Fried-Electronics/FE2201-MEPOS-STM32F405RGT6/KiCad/Pictures/220830 - PCB.jpg

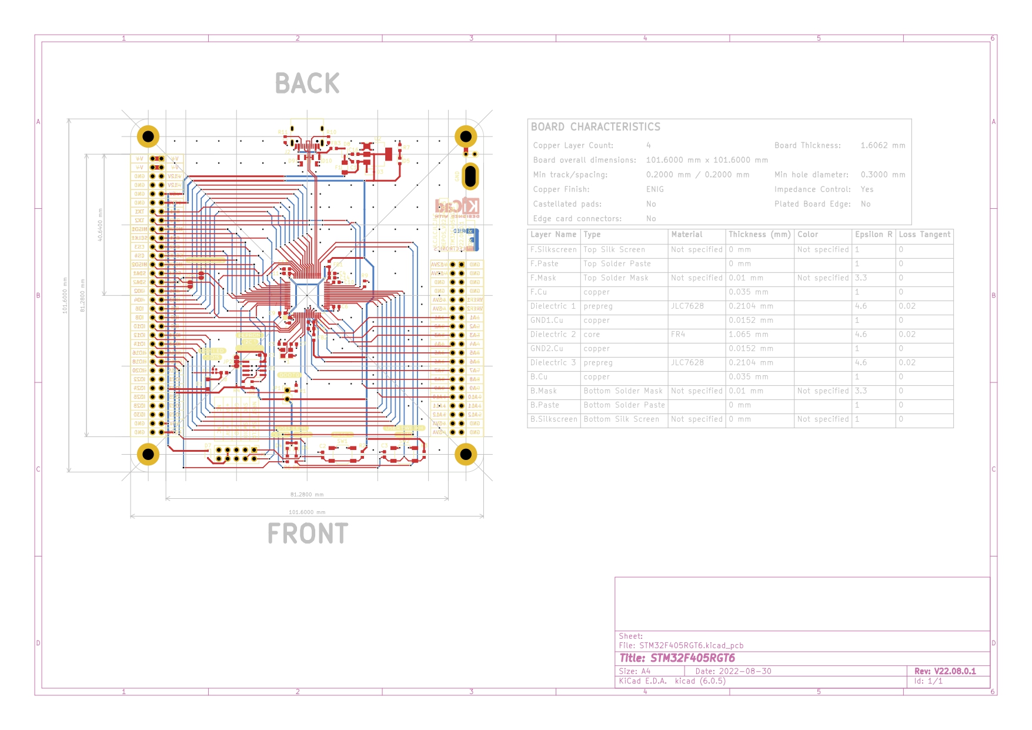
KiCad/Pictures/220830 - PCB.jpg
