Fried-Electronics/FE2201-MEPOS-STM32F405RGT6/KiCad/3D Models/STM32F405RGT6.step

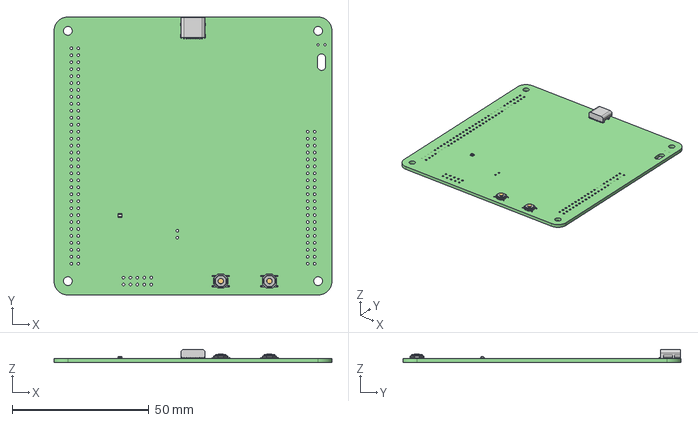
[picture p7: CAD file, 2022-09-21]
KiCad/3D Models/STM32F405RGT6.step
101.6 x 101.6 x 4.87 mm
STM32F405RGT6 PCB
