Fried-Electronics/FE2201-MEPOS-STM32F405RGT6/KiCad/220830 - Schematic.pdf

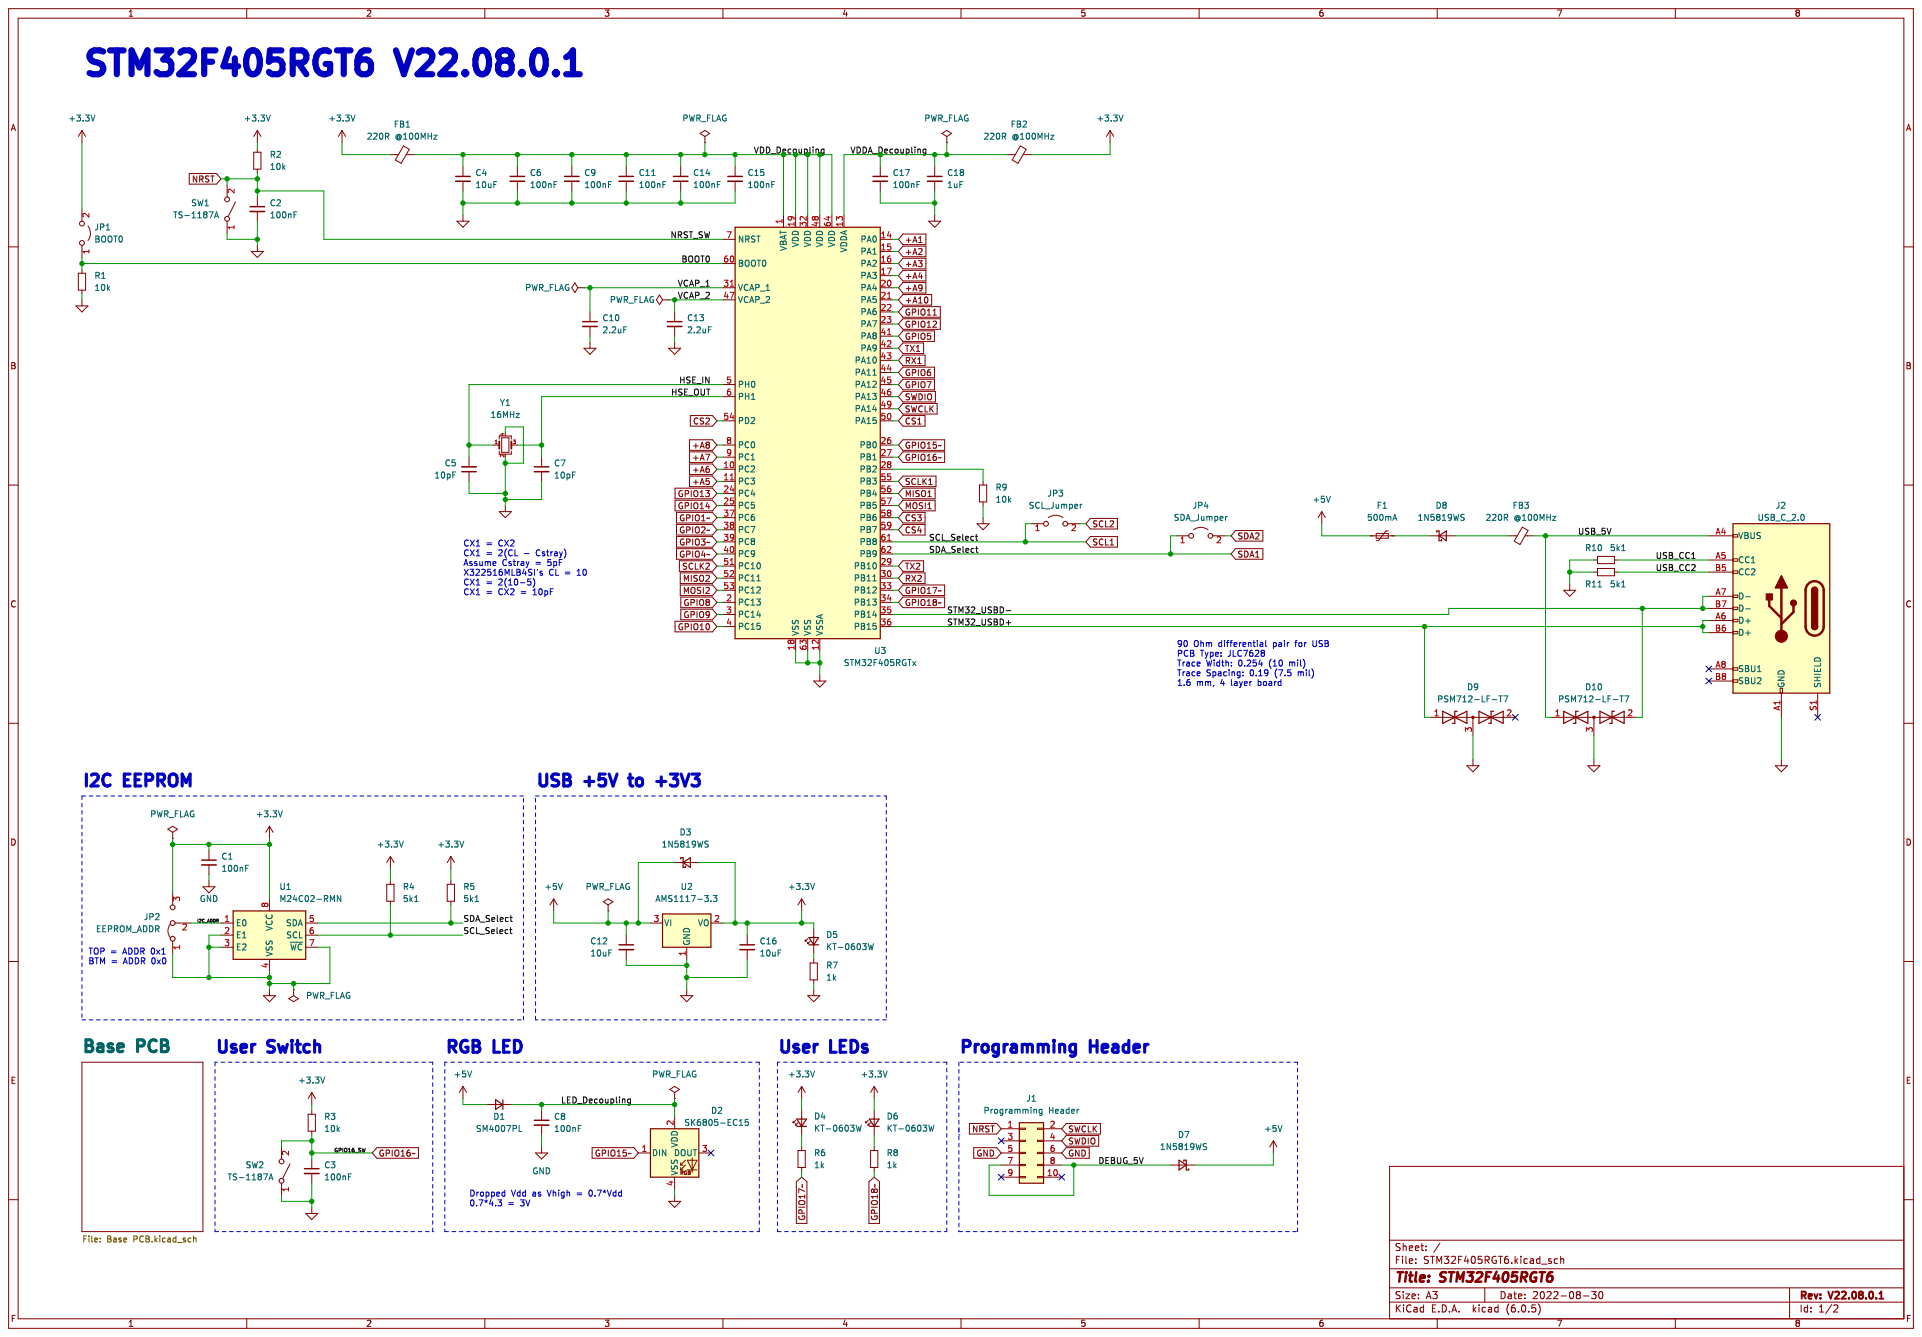
[picture p8: page 1]

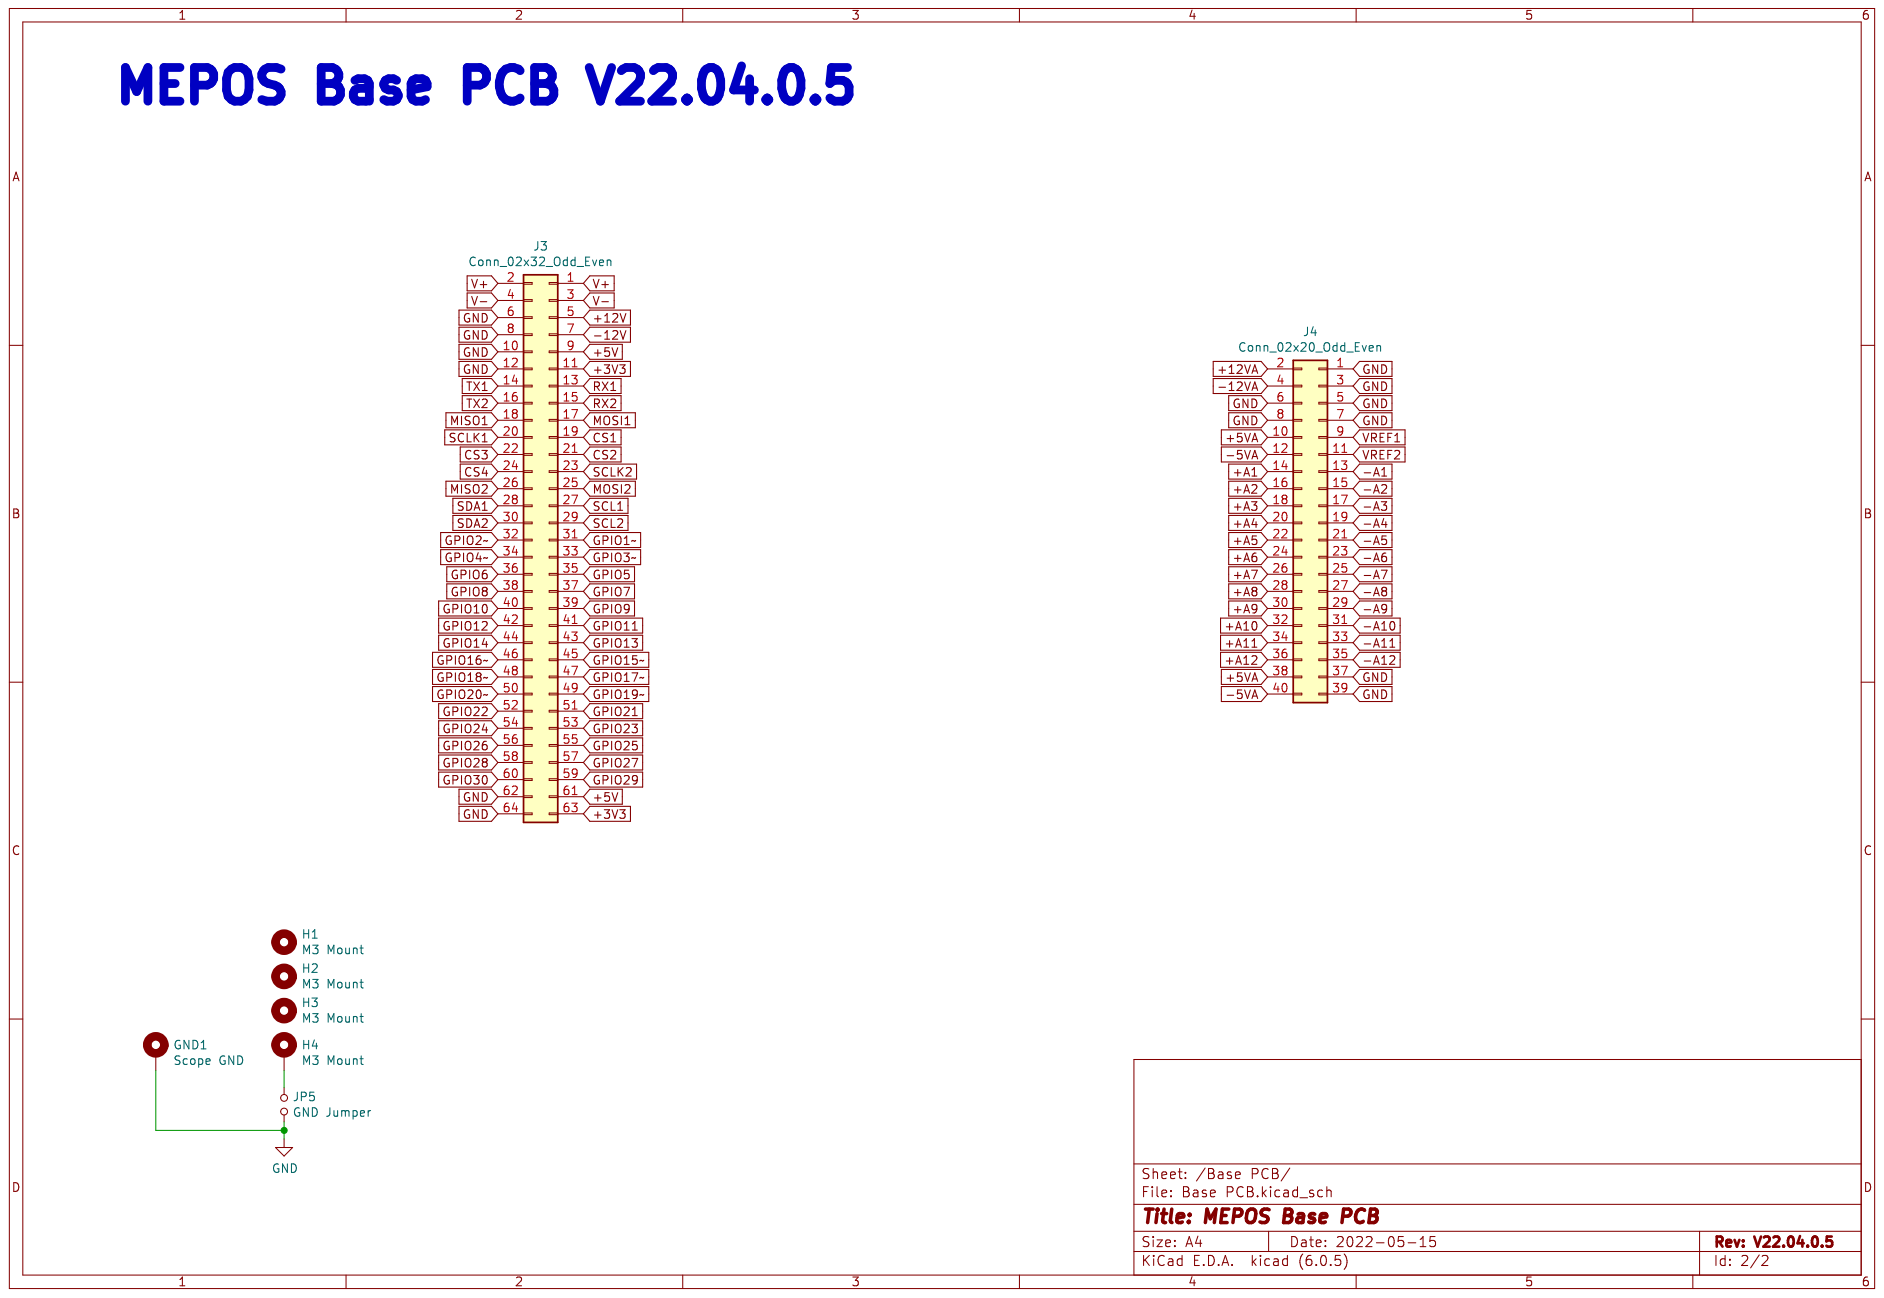
[picture p9: page 2]
