Fried-Electronics/FE2201-MEPOS-STM32F405RGT6/KiCad/220830 - PCB.pdf

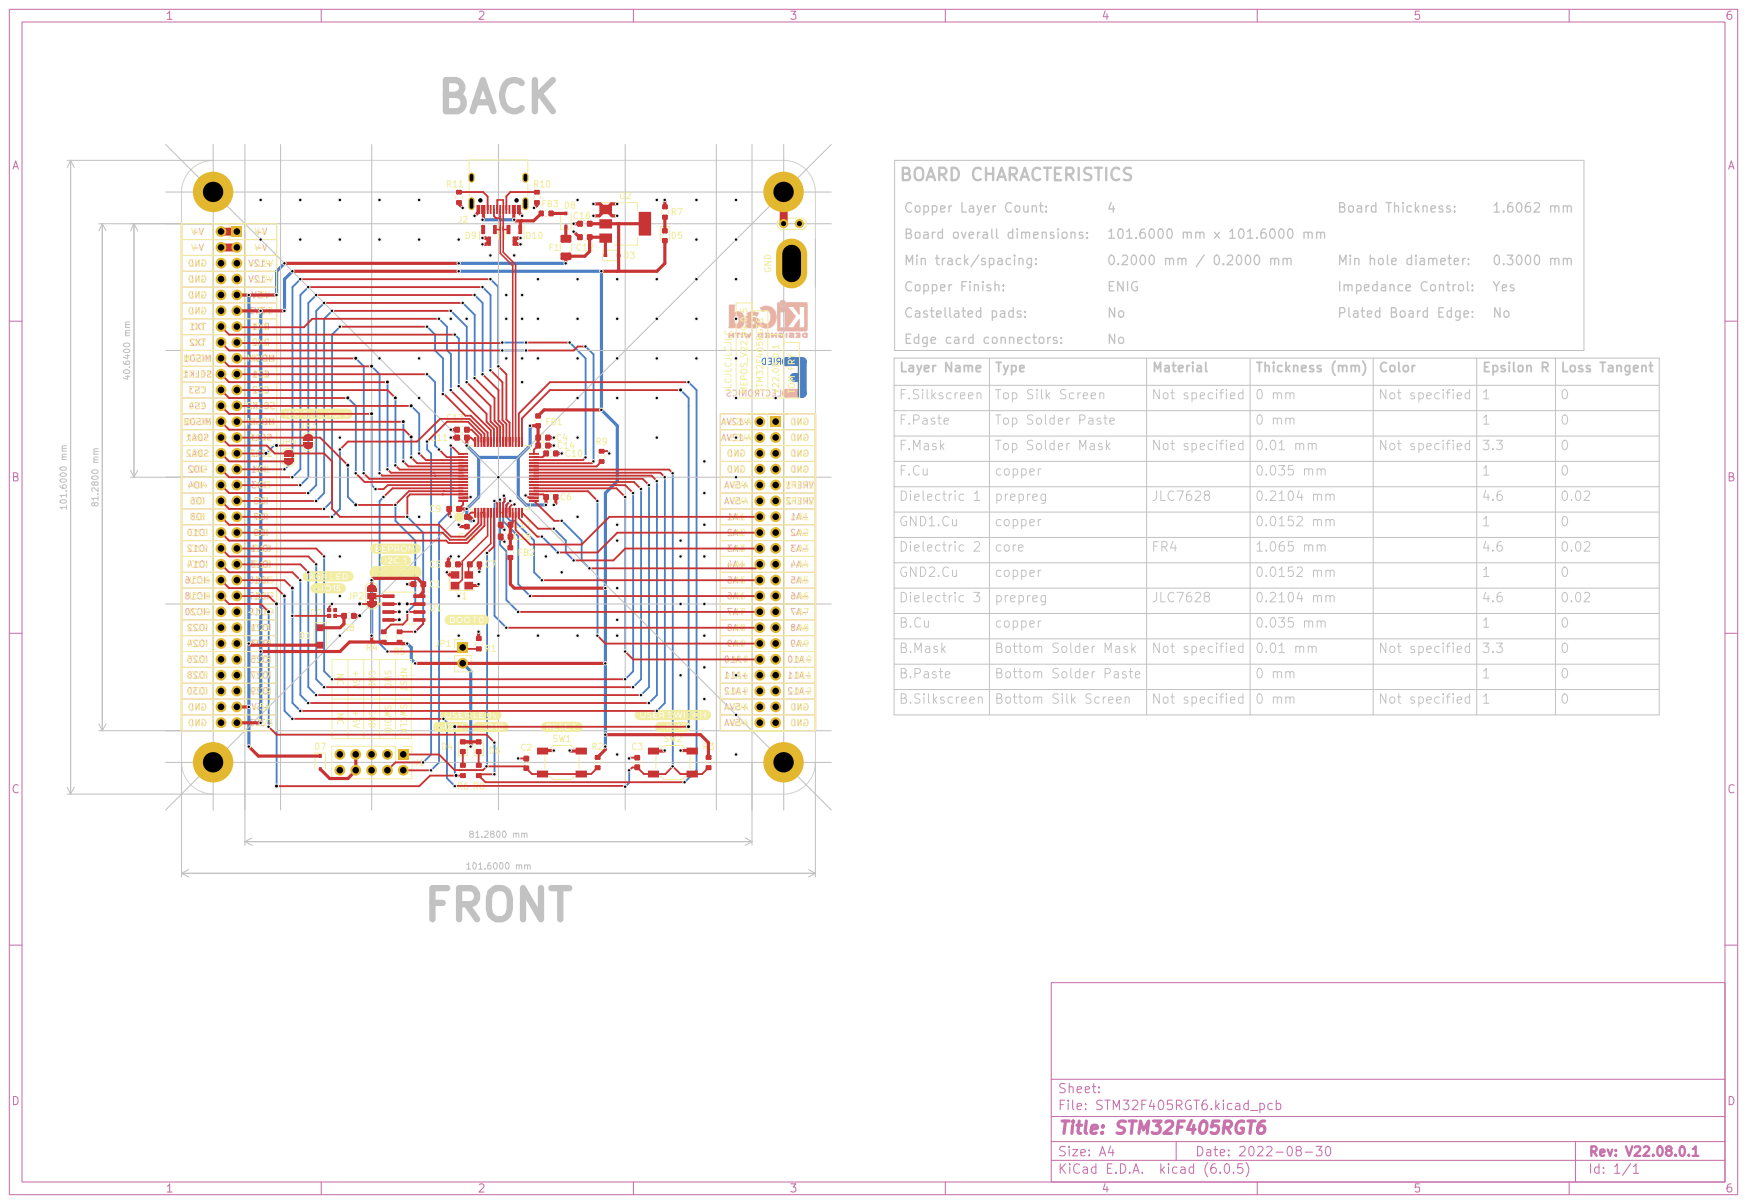
[picture p10: page 1]
