Fried-Electronics/FE2201-MEPOS-STM32F405RGT6/KiCad/STM32F405RGT6.kicad_pcb

## KiCad design KiCad/STM32F405RGT6.kicad_pcb (2022-09-21)

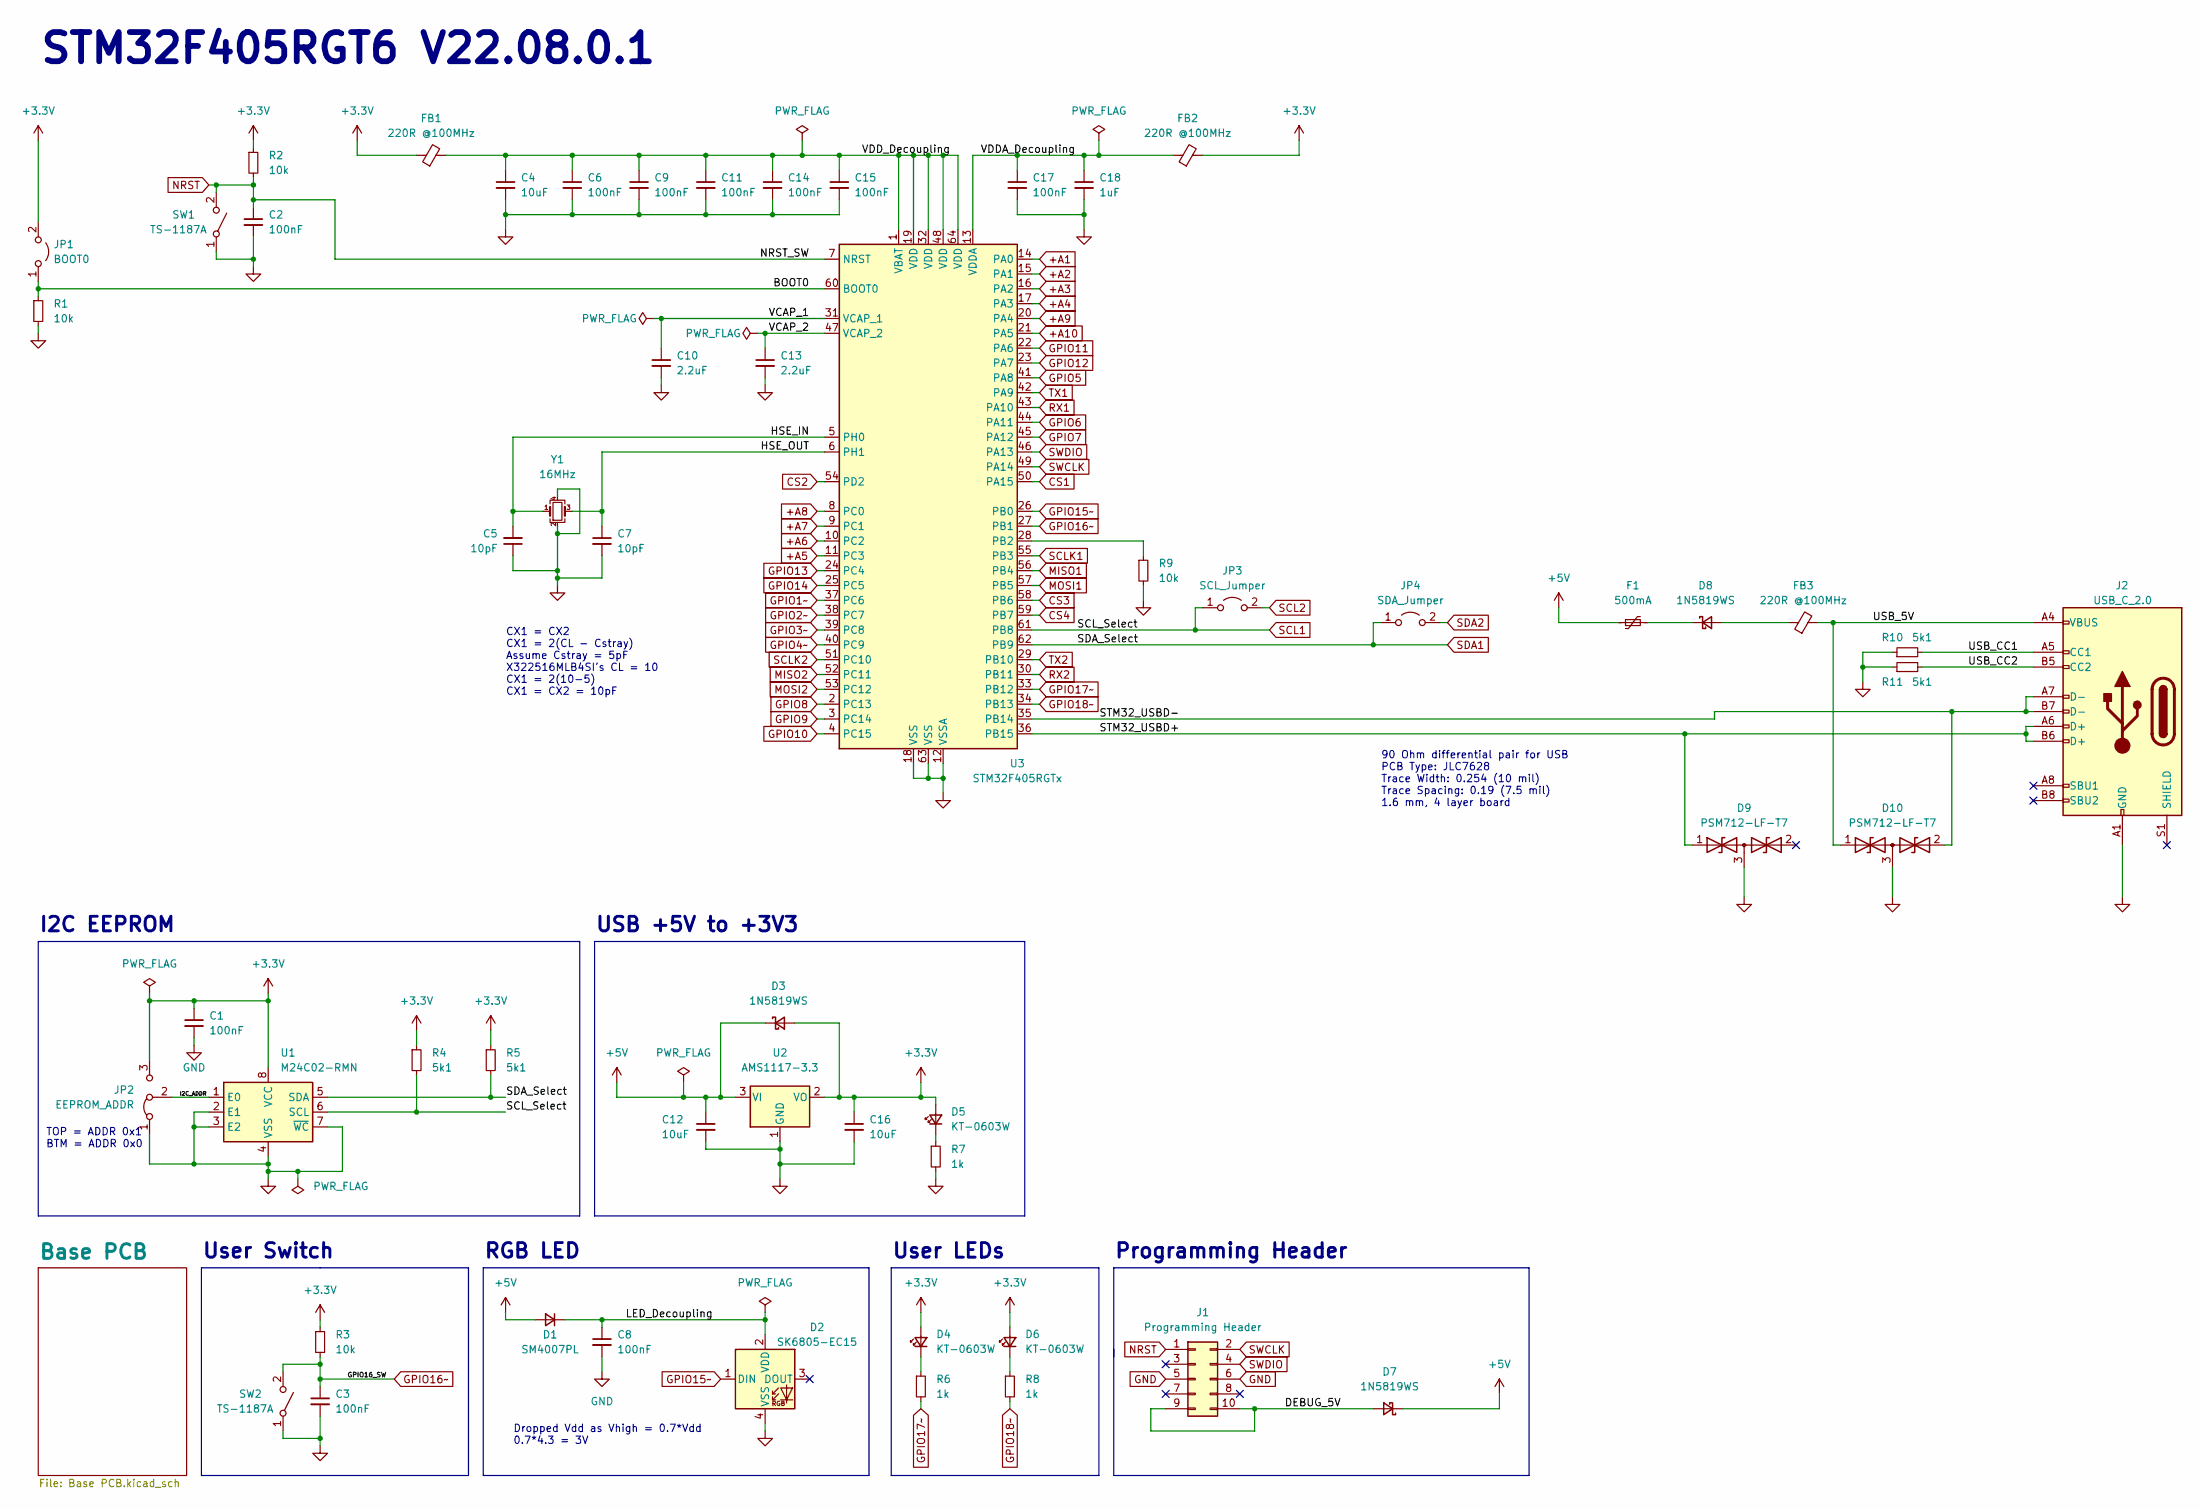
[picture p11: schematic STM32F405RGT6.kicad_sch]

Parts:
C1, C2, C3, C6, C8, C9, C11, C14, C15, C17: 100nF; C_0603_1608Metric; Part Number CC0603KRX7R9BB104; JLCPCB Part # C14663
C4, C12, C16: 10uF; C_0603_1608Metric; Part Number CL10A106KP8NNNC; JLCPCB Part # C19702
C5, C7: 10pF; C_0603_1608Metric; Part Number CL10C100JB8NNNC; JLCPCB Part # C1634
C10, C13: 2.2uF; C_0603_1608Metric; Part Number CL10A225KO8NNNC; JLCPCB Part # C23630
C18: 1uF; C_0603_1608Metric; Part Number CL10A105KB8NNNC; JLCPCB Part # C15849
D1: SM4007PL; D_SOD-123F; Part Number SM4007PL; JLCPCB Part # C64898
D2: SK6805-EC15
D3, D7, D8: 1N5819WS; D_SOD-323; Part Number 1N5819WS; JLCPCB Part # C191023
D4, D5, D6: KT-0603W; LED_0603_1608Metric; JLCPCB Part # C2290
D9, D10: PSM712-LF-T7; SOT-23; JLCPCB Part # C32677
F1: 500mA; Fuse_1206_3216Metric; Part Number JK-nSMD050-30; JLCPCB Part # C720075
FB1, FB2, FB3: 220R @100MHz; L_0603_1608Metric; Mouser Part Number 81-BLM18KG221SN1D
J1: Programming Header; PinHeader_2x05_P2.54mm_Horizontal; JLCPCB Part # C492433
J2: USB_C_2.0; USB_C_Receptacle_HRO_TYPE-C-31-M-12; Part Number TYPE-C-31-M-12; JLCPCB Part # C165948
JP1: BOOT0; PinHeader_1x02_P2.54mm_Vertical; Part Number PZ254V-11-02P; JLCPCB Part # C492401
JP2: EEPROM_ADDR; SolderJumper-3_P1.3mm_Bridged12_RoundedPad1.0x1.5mm
JP3: SCL_Jumper; SolderJumper-2_P1.3mm_Open_RoundedPad1.0x1.5mm
JP4: SDA_Jumper; SolderJumper-2_P1.3mm_Open_RoundedPad1.0x1.5mm
R1, R2, R3, R9: 10k; R_0603_1608Metric; Part Number 0603WAF1002T5E; JLCPCB Part # C25804
R4, R5, R10, R11: 5k1; R_0603_1608Metric; Part Number 0603WAF5101T5E; JLCPCB Part # C23186
R6, R7, R8: 1k; R_0603_1608Metric; Part Number 0603WAF1001T5E; JLCPCB Part # C21190
SW1, SW2: TS-1187A; SW_SPST_SKQG_WithStem; Part Number TS-1187A-B-A-B; JLCPCB Part # C318884
U1: M24C02-RMN; SOIC-8_3.9x4.9mm_P1.27mm; Mouser Part Number 511-M24C64-RMN6TP; JLCPCB Part # C79988
U2: AMS1117-3.3; SOT-223-3_TabPin2; Part Number AMS1117-3.3; JLCPCB Part # C6186
U3: STM32F405RGTx; LQFP-64_10x10mm_P0.5mm; Part Number STM32F405RGT6; JLCPCB Part # C15742
Y1: 16MHz; Crystal_SMD_3225-4Pin_3.2x2.5mm; Part Number X322516MLB4SI; JLCPCB Part # C13738

Connections:
+5V: C12.1, D1.2 (A), D3.1 (K), D7.1 (K), F1.1, U2.3 (VI); also elsewhere on the board
+A1: U3.14 (PA0); also elsewhere on the board
+A2: U3.15 (PA1); also elsewhere on the board
+A3: U3.16 (PA2); also elsewhere on the board
+A4: U3.17 (PA3); also elsewhere on the board
+A5: U3.11 (PC3); also elsewhere on the board
+A6: U3.10 (PC2); also elsewhere on the board
+A7: U3.9 (PC1); also elsewhere on the board
+A8: U3.8 (PC0); also elsewhere on the board
+A9: U3.20 (PA4); also elsewhere on the board
+A10: U3.21 (PA5); also elsewhere on the board
/BOOT0: JP1.1 (A), R1.1, U3.60 (BOOT0)
/DEBUG_5V: D7.2 (A), J1.9, J1.10
/HSE_IN: C5.2, U3.5 (PH0), Y1.1
/HSE_OUT: C7.1, U3.6 (PH1), Y1.3
/I2C_ADDR: JP2.2 (C), U1.1 (E0)
/LED_Decoupling: C8.1, D1.1 (K), D2.2 (VDD)
/STM32_USBD+: D9.1 (A1), J2.A6 (D+), J2.B6 (D+), U3.36 (PB15)
/STM32_USBD-: D10.2 (A2), J2.A7 (D-), J2.B7 (D-), U3.35 (PB14)
/USB_5V: D10.1 (A1), FB3.2, J2.A4 (VBUS), J2.A9 (VBUS), J2.B4 (VBUS), J2.B9 (VBUS)
/USB_CC1: J2.A5 (CC1), R10.2
/USB_CC2: J2.B5 (CC2), R11.2
/VCAP_1: C10.1, U3.31 (VCAP_1)
/VCAP_2: C13.1, U3.47 (VCAP_2)
/VDDA_Decoupling: C17.1, C18.1, FB2.1, U3.13 (VDDA)
/VDD_Decoupling: C4.1, C6.1, C9.1, C11.1, C14.1, C15.1, FB1.2, U3.1 (VBAT), U3.19 (VDD), U3.32 (VDD), U3.48 (VDD), U3.64 (VDD)
CS1: U3.50 (PA15); also elsewhere on the board
CS2: U3.54 (PD2); also elsewhere on the board
CS3: U3.58 (PB6); also elsewhere on the board
CS4: U3.59 (PB7); also elsewhere on the board
GND: C1.2, C2.2, C3.2, C4.2, C5.1, C6.2, C7.2, C8.2, C9.2, C10.2, C11.2, C12.2, C13.2, C14.2, C15.2, C16.2, C17.2, C18.2, D2.4 (VSS), D9.3 (common), D10.3 (common), J1.5, J1.6, J2.A1 (GND), J2.A12 (GND), J2.B1 (GND), J2.B12 (GND), JP2.1 (A), R1.2, R7.2, R9.2, R10.1, R11.1, SW1.1 (A), SW2.1 (A), U1.2 (E1), U1.3 (E2), U1.4 (VSS), U1.7 (~WC), U2.1 (GND), U3.12 (VSSA), U3.18 (VSS), U3.63 (VSS), Y1.2, Y1.4; also elsewhere on the board
GPIO1~: U3.37 (PC6); also elsewhere on the board
GPIO2~: U3.38 (PC7); also elsewhere on the board
GPIO3~: U3.39 (PC8); also elsewhere on the board
GPIO4~: U3.40 (PC9); also elsewhere on the board
GPIO5: U3.41 (PA8); also elsewhere on the board
GPIO6: U3.44 (PA11); also elsewhere on the board
GPIO7: U3.45 (PA12); also elsewhere on the board
GPIO8: U3.2 (PC13); also elsewhere on the board
GPIO9: U3.3 (PC14); also elsewhere on the board
GPIO10: U3.4 (PC15); also elsewhere on the board
GPIO11: U3.22 (PA6); also elsewhere on the board
GPIO12: U3.23 (PA7); also elsewhere on the board
GPIO13: U3.24 (PC4); also elsewhere on the board
GPIO14: U3.25 (PC5); also elsewhere on the board
GPIO15~: D2.1 (DIN), U3.26 (PB0); also elsewhere on the board
GPIO16~: C3.1, R3.2, SW2.2 (B), U3.27 (PB1); also elsewhere on the board
GPIO17~: R6.2, U3.33 (PB12); also elsewhere on the board
GPIO18~: R8.2, U3.34 (PB13); also elsewhere on the board
MISO1: U3.56 (PB4); also elsewhere on the board
MISO2: U3.52 (PC11); also elsewhere on the board
MOSI1: U3.57 (PB5); also elsewhere on the board
MOSI2: U3.53 (PC12); also elsewhere on the board
NRST: C2.1, J1.1, R2.2, SW1.2 (B), U3.7 (NRST)
unnamed: D4.1 (K), R6.1
unnamed: D5.1 (K), R7.1
unnamed: D6.1 (K), R8.1
unnamed: D8.1 (K), F1.2
unnamed: D8.2 (A), FB3.1
unnamed: R9.1, U3.28 (PB2)
RX1: U3.43 (PA10); also elsewhere on the board
RX2: U3.30 (PB11); also elsewhere on the board
SCL1: JP3.1 (A), R4.2, U1.6 (SCL), U3.61 (PB8); also elsewhere on the board
SCL2: JP3.2 (B); also elsewhere on the board
SCLK1: U3.55 (PB3); also elsewhere on the board
SCLK2: U3.51 (PC10); also elsewhere on the board
SDA1: JP4.1 (A), R5.2, U1.5 (SDA), U3.62 (PB9); also elsewhere on the board
SDA2: JP4.2 (B); also elsewhere on the board
SWCLK: J1.2, U3.49 (PA14)
SWDIO: J1.4, U3.46 (PA13)
TX1: U3.42 (PA9); also elsewhere on the board
TX2: U3.29 (PB10); also elsewhere on the board

Notes on the sheet:
USB +5V to +3V3
CX1 = CX2 CX1 = 2(CL - Cstray) Assume Cstray = 5pF X322516MLB4SI's CL = 10 CX1 = 2(10-5) CX1 = CX2 = 10pF
User LEDs
RGB LED
TOP = ADDR 0x1 BTM = ADDR 0x0
STM32F405RGT6 V22.08.0.1
I2C EEPROM
Programming Header
Dropped Vdd as Vhigh = 0.7*Vdd 0.7*4.3 = 3V
User Switch
90 Ohm differential pair for USB PCB Type: JLC7628 Trace Width: 0.254 (10 mil) Trace Spacing: 0.19 (7.5 mil) 1.6 mm, 4 layer board

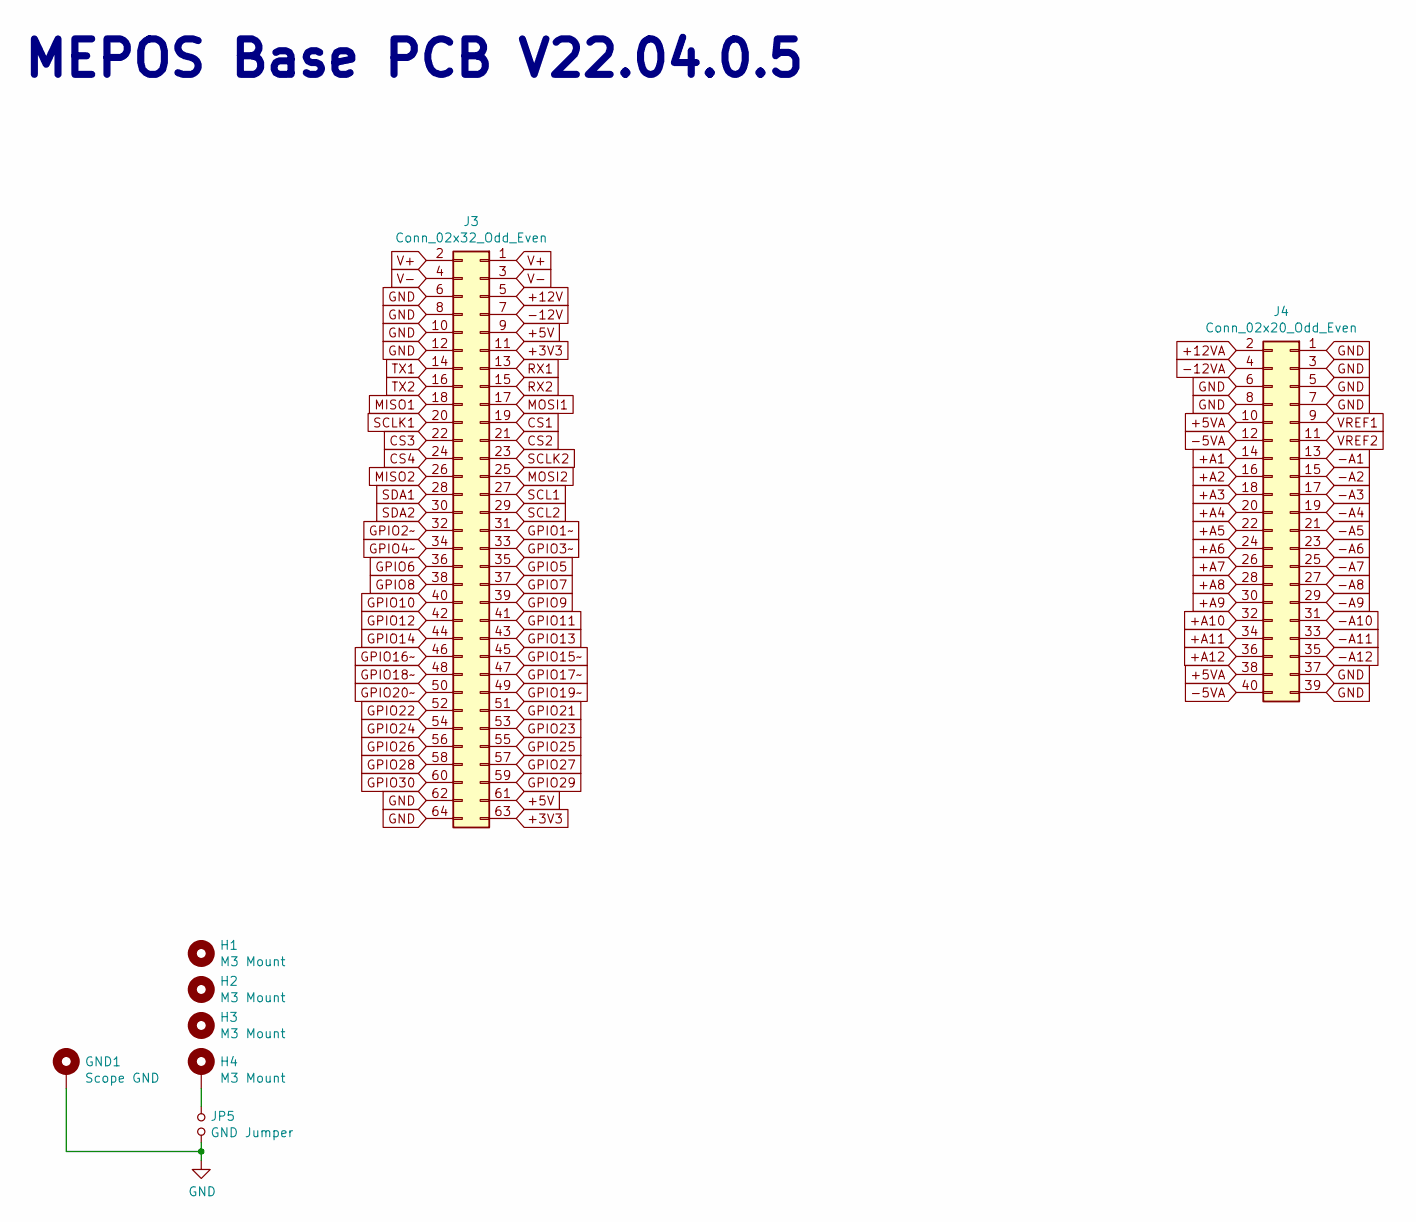
[picture p12: schematic Base PCB.kicad_sch, MEPOS Base PCB]

Parts:
GND1: Scope GND; Scope_GND
H1, H2, H3, H4: M3 Mount; MountingHole_3.2mm_M3_Pad
J3: Conn_02x32_Odd_Even; PinSocket_2x32_P2.54mm_Vertical
J4: Conn_02x20_Odd_Even; PinSocket_2x20_P2.54mm_Vertical
JP5: GND Jumper; TestPoint_2Pads_Pitch2.54mm_Drill0.8mm

Connections:
+5V: J3.9, J3.61; also elsewhere on the board
+5VA: J4.10, J4.38
+12V: J3.5
+12VA: J4.2
+A1: J4.14; also elsewhere on the board
+A2: J4.16; also elsewhere on the board
+A3: J4.18; also elsewhere on the board
+A4: J4.20; also elsewhere on the board
+A5: J4.22; also elsewhere on the board
+A6: J4.24; also elsewhere on the board
+A7: J4.26; also elsewhere on the board
+A8: J4.28; also elsewhere on the board
+A9: J4.30; also elsewhere on the board
+A10: J4.32; also elsewhere on the board
+A11: J4.34
+A12: J4.36
-5VA: J4.12, J4.40
-12V: J3.7
-12VA: J4.4
-A1: J4.13
-A2: J4.15
-A3: J4.17
-A4: J4.19
-A5: J4.21
-A6: J4.23
-A7: J4.25
-A8: J4.27
-A9: J4.29
-A10: J4.31
-A11: J4.33
-A12: J4.35
CS1: J3.19; also elsewhere on the board
CS2: J3.21; also elsewhere on the board
CS3: J3.22; also elsewhere on the board
CS4: J3.24; also elsewhere on the board
GND: GND1.1, J3.6, J3.8, J3.10, J3.12, J3.62, J3.64, J4.1, J4.3, J4.5, J4.6, J4.7, J4.8, J4.37, J4.39, JP5.2; also elsewhere on the board
GPIO1~: J3.31; also elsewhere on the board
GPIO2~: J3.32; also elsewhere on the board
GPIO3~: J3.33; also elsewhere on the board
GPIO4~: J3.34; also elsewhere on the board
GPIO5: J3.35; also elsewhere on the board
GPIO6: J3.36; also elsewhere on the board
GPIO7: J3.37; also elsewhere on the board
GPIO8: J3.38; also elsewhere on the board
GPIO9: J3.39; also elsewhere on the board
GPIO10: J3.40; also elsewhere on the board
GPIO11: J3.41; also elsewhere on the board
GPIO12: J3.42; also elsewhere on the board
GPIO13: J3.43; also elsewhere on the board
GPIO14: J3.44; also elsewhere on the board
GPIO15~: J3.45; also elsewhere on the board
GPIO16~: J3.46; also elsewhere on the board
GPIO17~: J3.47; also elsewhere on the board
GPIO18~: J3.48; also elsewhere on the board
GPIO19~: J3.49
GPIO20~: J3.50
GPIO21: J3.51
GPIO22: J3.52
GPIO23: J3.53
GPIO24: J3.54
GPIO25: J3.55
GPIO26: J3.56
GPIO27: J3.57
GPIO28: J3.58
GPIO29: J3.59
GPIO30: J3.60
MISO1: J3.18; also elsewhere on the board
MISO2: J3.26; also elsewhere on the board
MOSI1: J3.17; also elsewhere on the board
MOSI2: J3.25; also elsewhere on the board
unnamed: H4.1, JP5.1
RX1: J3.13; also elsewhere on the board
RX2: J3.15; also elsewhere on the board
SCL1: J3.27; also elsewhere on the board
SCL2: J3.29; also elsewhere on the board
SCLK1: J3.20; also elsewhere on the board
SCLK2: J3.23; also elsewhere on the board
SDA1: J3.28; also elsewhere on the board
SDA2: J3.30; also elsewhere on the board
TX1: J3.14; also elsewhere on the board
TX2: J3.16; also elsewhere on the board
V+: J3.1, J3.2
V-: J3.3, J3.4
VREF1: J4.9
VREF2: J4.11

Notes on the sheet:
MEPOS Base PCB V22.04.0.5

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
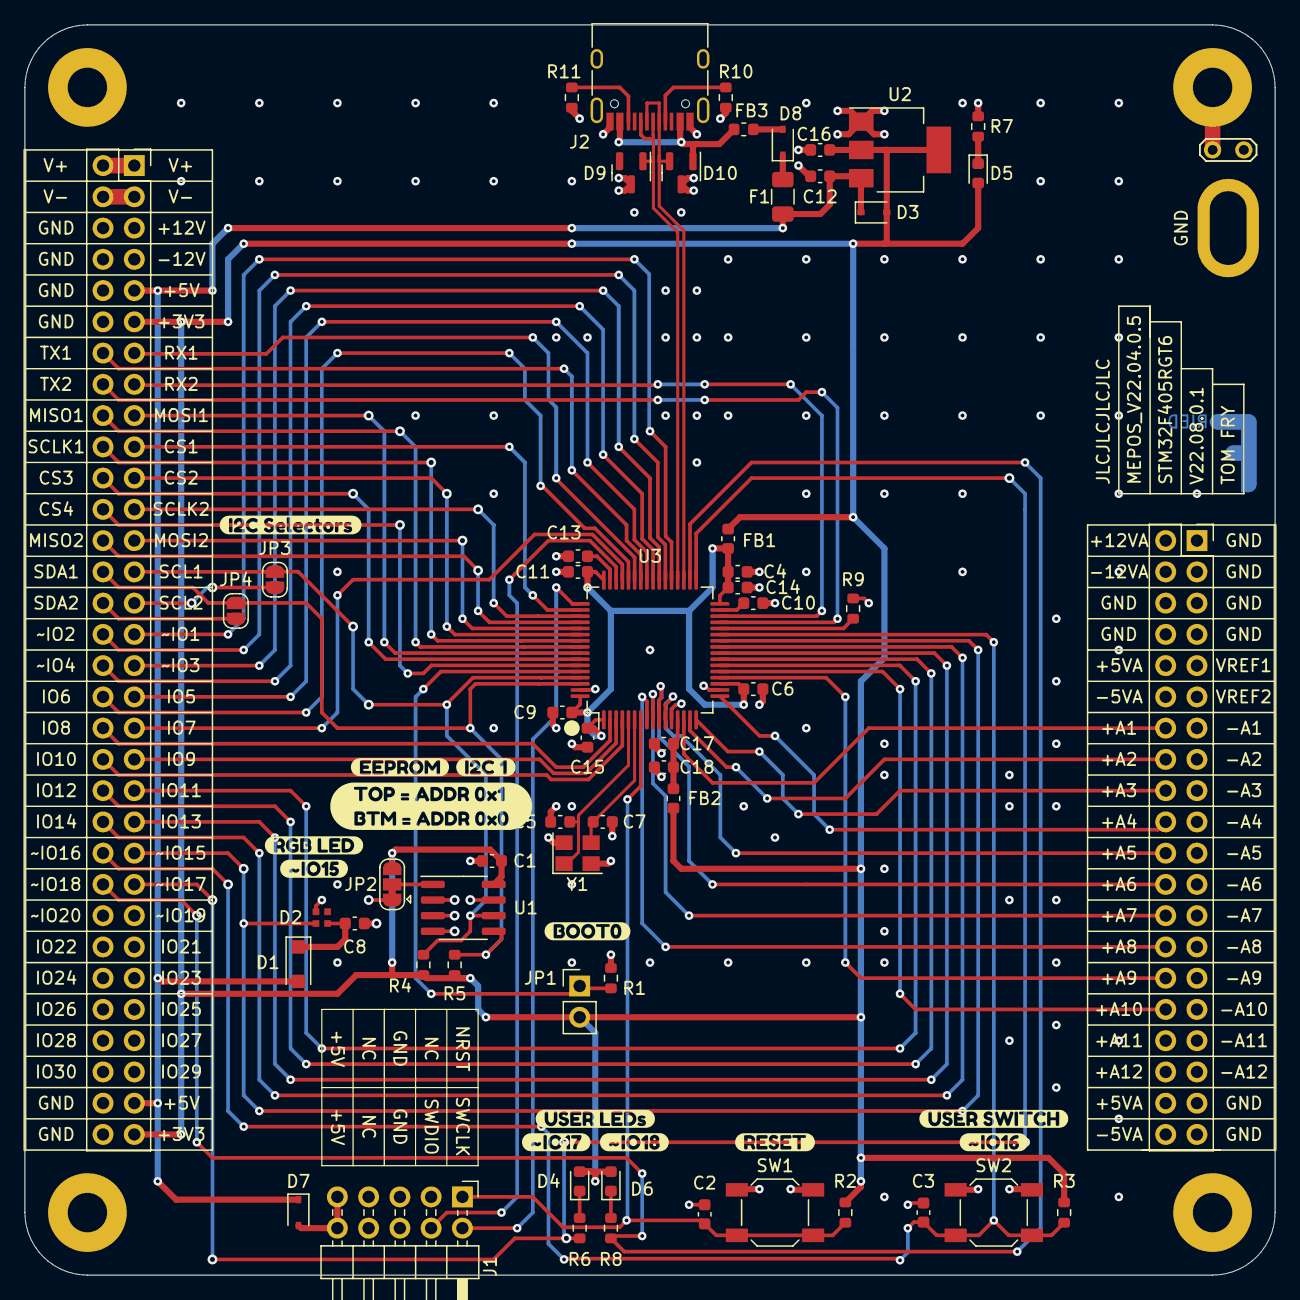
[picture p13: board STM32F405RGT6.kicad_pcb from above]

Board: 4 copper layers, 101.6 x 101.6 mm, 77 parts (1 on the bottom side), 78 nets.

Other parts of the board:
KiCad_Logo: KiCad-Logo2_5mm_SilkScreen
kibuzzard-630B16ED: G***; kibuzzard-630B16ED
kibuzzard-630B17C2: G***; kibuzzard-630B17C2
kibuzzard-630B17D9: G***; kibuzzard-630B17D9
kibuzzard-630B17E2: G***; kibuzzard-630B17E2
kibuzzard-630B175D: G***; kibuzzard-630B175D
kibuzzard-630B176C: G***; kibuzzard-630B176C
kibuzzard-630B178A: G***; kibuzzard-630B178A
kibuzzard-630B1710: G***; kibuzzard-630B1710
kibuzzard-630B1728: G***; kibuzzard-630B1728
kibuzzard-630B1736: G***; kibuzzard-630B1736
kibuzzard-630B1749: G***; kibuzzard-630B1749
kibuzzard-630B1806: G***; kibuzzard-630B1806
kibuzzard-632AC88F: G***; kibuzzard-632AC88F
