Fried-Electronics/FE2201-MEPOS-STM32F405RGT6/STM32 Software/EEPROM/Core/Inc/main.h

#define SWDIO_Pin GPIO_PIN_13
#define SWDIO_GPIO_Port GPIOA
#define SWCLK_Pin GPIO_PIN_14
#define SWCLK_GPIO_Port GPIOA
#define SCL1_2_Pin GPIO_PIN_8
#define SCL1_2_GPIO_Port GPIOB
#define SDA1_2_Pin GPIO_PIN_9
#define SDA1_2_GPIO_Port GPIOB
