Fried-Electronics/FE2201-MEPOS-STM32F405RGT6/(commit log)

2022-05-23 Create Project Files
    [Base PCB.kicad_sch, STM32F405RGT6.kicad_pcb, STM32F405RGT6.kicad_sch]
2022-05-23 Added prototype components to schematic
    [STM32F405RGT6.kicad_pcb, STM32F405RGT6.kicad_sch]
2022-05-23 Added Components to the Schematic and PCB
    [STM32F405RGT6.kicad_pcb, STM32F405RGT6.kicad_sch]
2022-05-24 Updated Schematic and PCB
    [STM32F405RGT6.kicad_pcb, STM32F405RGT6.kicad_sch]
2022-06-09 Added components to schematic
    [STM32F405RGT6.kicad_pcb, STM32F405RGT6.kicad_sch]
2022-06-09 Updated STM32 Cube and KiCad files
    [STM32F405RGT6.kicad_pcb, STM32F405RGT6.kicad_sch]
2022-06-10 Update Schematic and PCB
    [STM32F405RGT6.kicad_pcb, STM32F405RGT6.kicad_sch]
2022-06-28 Updated PCB and Schematic
    [STM32F405RGT6.kicad_pcb, STM32F405RGT6.kicad_sch]
2022-06-30 Removed FTDI chip and rearranged pinout
    [STM32F405RGT6.kicad_pcb, STM32F405RGT6.kicad_sch]
2022-06-30 Updated Schematic to STM32 software
    [STM32F405RGT6.kicad_pcb, STM32F405RGT6.kicad_sch]
2022-07-01 Updated Schematic and BOM
    [STM32F405RGT6.kicad_pcb, STM32F405RGT6.kicad_sch]
2022-07-11 Added CCU Resistors
    [Base PCB.kicad_sch, STM32F405RGT6.kicad_sch]
2022-07-11 Updated to newer MEPOS Library
    [Base PCB.kicad_sch, STM32F405RGT6.kicad_pcb, STM32F405RGT6.kicad_sch]
2022-07-11 added USB 3D model and PTC fuse
    [Base PCB.kicad_sch, STM32F405RGT6.kicad_pcb, STM32F405RGT6.kicad_sch]
2022-07-12 added USB differential pair info
    [STM32F405RGT6.kicad_pcb, STM32F405RGT6.kicad_sch]
2022-07-12 Added stack up and differential pair size
    [STM32F405RGT6.kicad_pcb, STM32F405RGT6.kicad_sch]
2022-07-12 Added part numbers to most parts
    [STM32F405RGT6.kicad_pcb, STM32F405RGT6.kicad_sch]
2022-07-12 Updated ADC pinning for better routing
    [STM32F405RGT6.kicad_pcb]
2022-07-12 Added VCP Driver
2022-07-14 Started Routing
    [Base PCB.kicad_sch, STM32F405RGT6.kicad_pcb, STM32F405RGT6.kicad_sch]
2022-07-14 Updated Routing
    [STM32F405RGT6.kicad_pcb]
2022-07-21 Updated PCB
    [STM32F405RGT6.kicad_pcb]
2022-07-26 Fixed some DRC errors
    [STM32F405RGT6.kicad_pcb]
2022-08-26 Changed Pin Mapping
    [Base PCB.kicad_sch, STM32F405RGT6.kicad_pcb, STM32F405RGT6.kicad_sch]
2022-08-27 Changed some components
    added a PNP mosfet onto the onboard 3.3V regulator to stop the diode drop.
    changed the ESD protection on the USB to allow for more clearance
    [Base PCB.kicad_sch, STM32F405RGT6.kicad_pcb, STM32F405RGT6.kicad_sch]
2022-08-28 Added Datasheets
    [Base PCB.kicad_sch, STM32F405RGT6.kicad_pcb, STM32F405RGT6.kicad_sch]
2022-08-28 Updated silkscreen text to labels
    [STM32F405RGT6.kicad_pcb]
2022-08-30 Schematic and BOM Checked
    [Base PCB.kicad_sch, STM32F405RGT6.kicad_pcb, STM32F405RGT6.kicad_sch]
2022-08-30 Update STM32F405RGT6.kicad_pcb
    Stitched GND planes together
    [STM32F405RGT6.kicad_pcb]
2022-08-30 Updated title block and created PDF
    [STM32F405RGT6.kicad_pcb]
2022-08-30 Generated Gerbers
    [STM32F405RGT6-B_Cu.gbr, STM32F405RGT6-B_Mask.gbr, STM32F405RGT6-B_Paste.gbr, STM32F405RGT6-B_Silkscreen.gbr, STM32F405RGT6-Edge_Cuts.gbr, STM32F405RGT6-F_Cu.gbr, STM32F405RGT6-F_Mask.gbr, STM32F405RGT6-F_Paste.gbr]
2022-08-30 Update STM32F405RGT6.kicad_sch
    Updated title block
    [STM32F405RGT6.kicad_sch]
2022-08-30 Changed SK6805 Footprint and plotted
    [Base PCB.kicad_sch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]
2022-08-30 Changed Structure
    Moved STM32 files into "DEFAULT" Folder so that other projects like "ASCII Parser" can be built from it
2022-08-30 Update 220830 - Schematic.pdf
2022-08-30 Update 220830 - PCB.pdf
2022-09-09 Updated Debug Header
    [STM32F405RGT6.kicad_pcb, STM32F405RGT6.kicad_sch]
2022-09-09 Fixed debug silkscreen
    [STM32F405RGT6.kicad_pcb]
2022-09-13 Created RGB LED project
2022-09-14 Code now works on board
2022-09-14 Rough working rainbow LED
2022-09-21 Changed J1 to right angle connector and created 3D model
    [STM32F405RGT6.kicad_pcb, STM32F405RGT6.kicad_sch, STM32F405RGT6.step]
2022-09-21 Updated 3D model
    [STM32F405RGT6.kicad_pcb]
