Fried-Electronics/FE2201-MEPOS-STM32F405RGT6/(notices)

Notices in the files:
STM32 Software/EEPROM/Core/Inc/main.h:
Copyright (c) 2022 STMicroelectronics.
All rights reserved.
This software is licensed under terms that can be found in the LICENSE file
